SMACY2017/AI-Wings/README.md

# AI Wings Project

> Hold by the Microsoft Garage GCR for Hackathon 2023

## Related SharePoint Resources

[AI Wings sharepoint](https://microsoft.sharepoint.com/:f:/t/TheGarageBeijing/ElnYJoaCk3hEr9XLdqNrPawBjEY0E-VvGR7ijOIGqmrDCg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)

## Brief Introduction

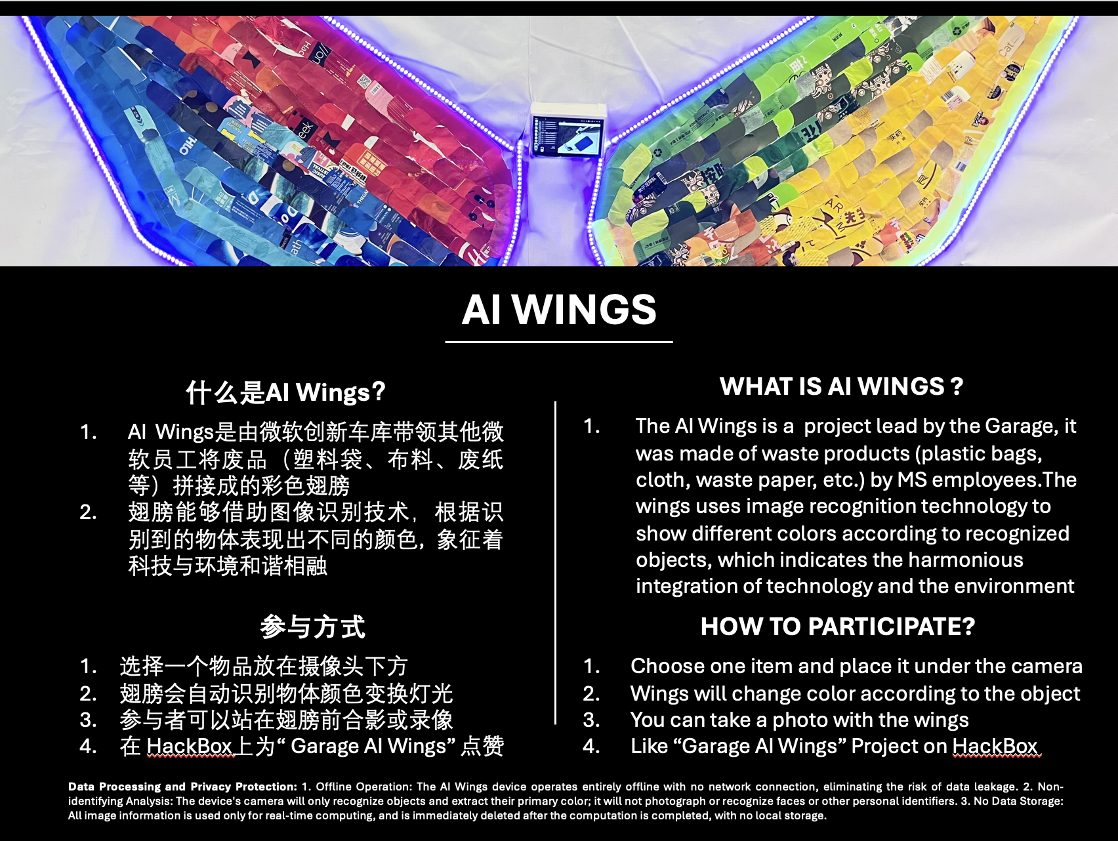
[picture p1: assets/Intro.png]
Intro


## Technique Details
**[所需材料以及技术文档请参见这里](https://github.com/SMACY2017/AI-Wings/tree/main/code)**

## Assembly details

#### **注：需要2-3名Leader全程负责翅膀的整个流程直到布置上线**

1. 取出背景布，平铺在桌面上，布面尺寸 `2.3 m * 3.05 m`。

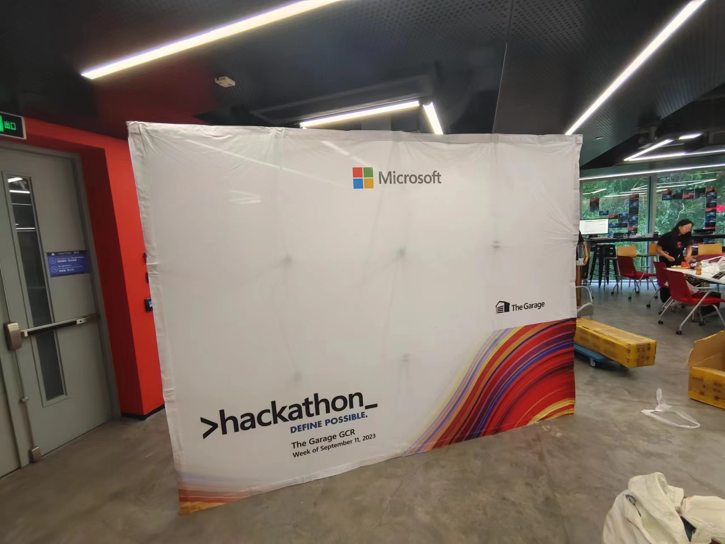
[picture p2: assets/background.jpg]
background
   
2. 勾勒翅膀外观尺寸和硬件电路固定。

   > 推荐人数：8 人（粘贴轮廓 4人， 灯带等硬件 4人 + 2 个Leader）
   >
   > 推荐场次：1 场（该场活动安排在[@MengShi](mailto:v-mengshi@microsoft.com)以及[@Xiang Yu](mailto:v-xiangyu1@microsoft.com)到达的第一天）
   >
   > 推荐时间：60 min
   >

   根据 `./utils/wings.png`（1.4m * 2.9 m）用铅笔在布面同比例进行关键点尺寸标定，先在周围粘贴一圈羽毛进行轮廓敲定。然后使用细铁丝加胶带等材料进行灯带的固定，以及电路的布局和固定。

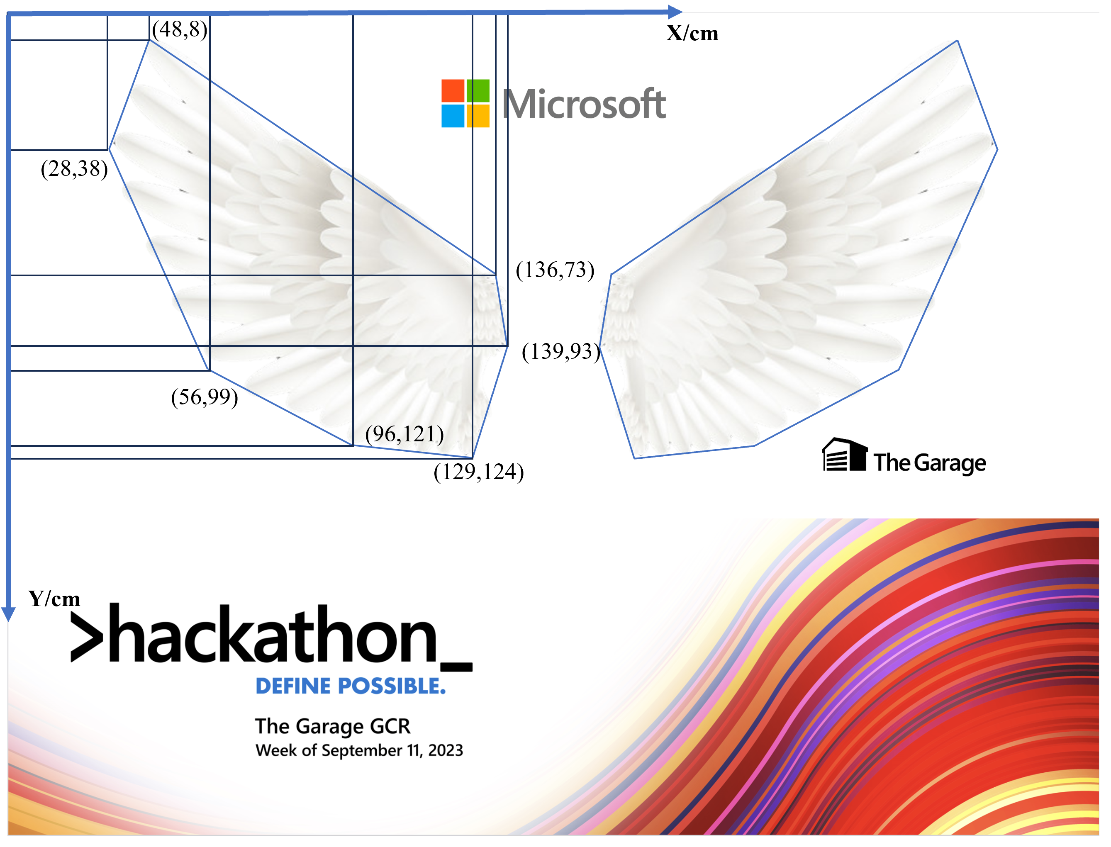
[picture p3: assets/backgroung.png]
backgroung
   

   <p align="center">
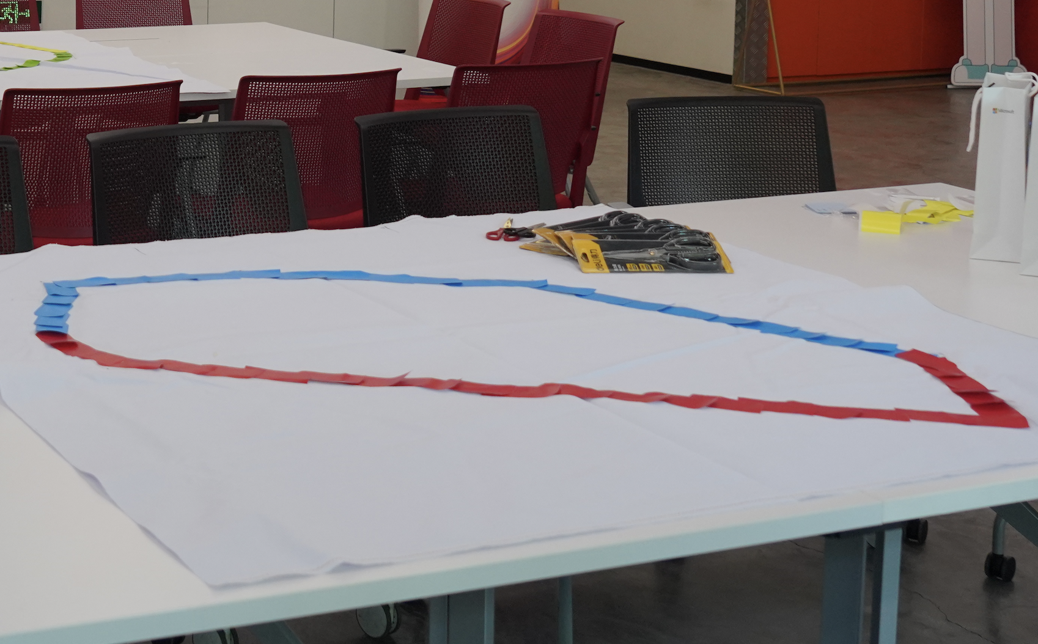
[picture p4: assets/outline-2341196.png]
outline
        
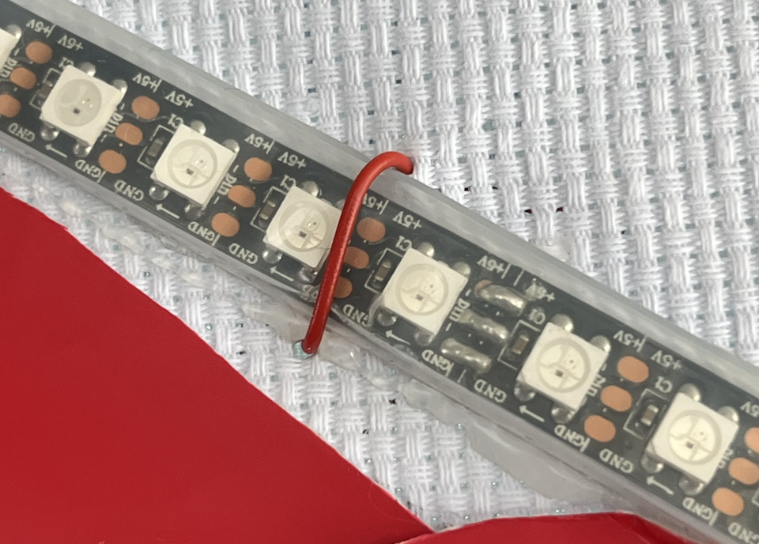
[picture p5: assets/zadai.png]
zadai
     
   </p>
3. **要求参与者携带微软四色（红、绿、蓝、黄）的垃圾袋**，SiteLead 打印翅膀模版文件 `./utils/feather.pdf`发给参与者，参与者们按照提供的翅膀模版图片进行剪裁**（不推荐使用塑料袋等薄而易卷的材料）**。

   > 推荐人数：40 人（每颜色10人剪裁翅膀，200片羽毛/颜色，平均每人裁剪20片）
   >
   > 推荐场次：2 场（20人/场）
   >
   > 推荐时间：45 min / 场（5 min讲解，讲解PPT参考[Garage 线下工作坊 亲手制作AI翅膀.pptx (sharepoint.com)](https://microsoft.sharepoint.com/:p:/r/teams/TheGarageBeijing/_layouts/15/Doc.aspx?sourcedoc={BF3407C9-1596-4903-8D87-60C0FF299C23}&file=Garage 线下工作坊 亲手制作AI翅膀.pptx&action=edit&mobileredirect=true&share=IQHJBzS_lhUDSY2HYMD_KZwjAZ7fnG6qvlRCYcBTRel2ibE)）
   >

   - 剪裁完成后，需要**留下8人进行两边翅膀的粘贴工作，SiteLead进行粘贴品控的监督**。
   - 粘贴羽毛时，采用层叠样式，从翅尖到翅根，一片盖一片
   - 翅膀需要加压晾干一天

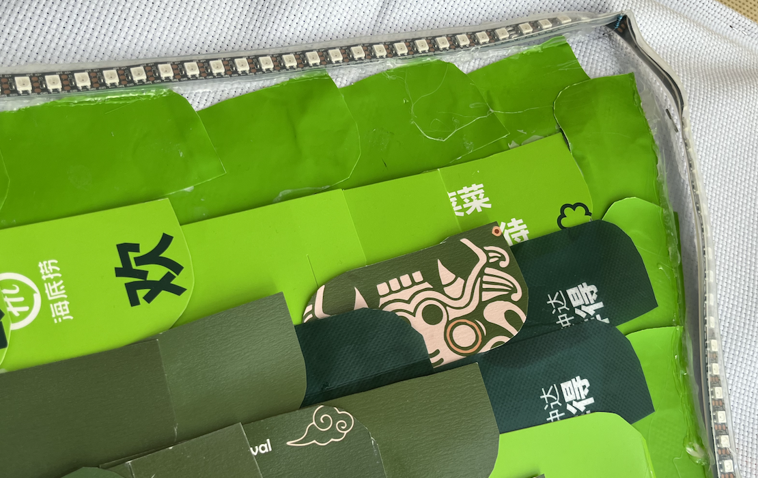
[picture p6: assets/Screenshot 2023-08-18 at 14.39.10.png]
     
4. Leader（组织2-3人）进行最后的组装和维护

   > 推荐人数：2 人
   >
   > 以下内容将会在第一场活动的时候由 Intern 向各个Site的Leader进行具体演示
   >

   - 显示屏安装、固定、接线
   - 灯带接线
   - 电源、启动、开关机

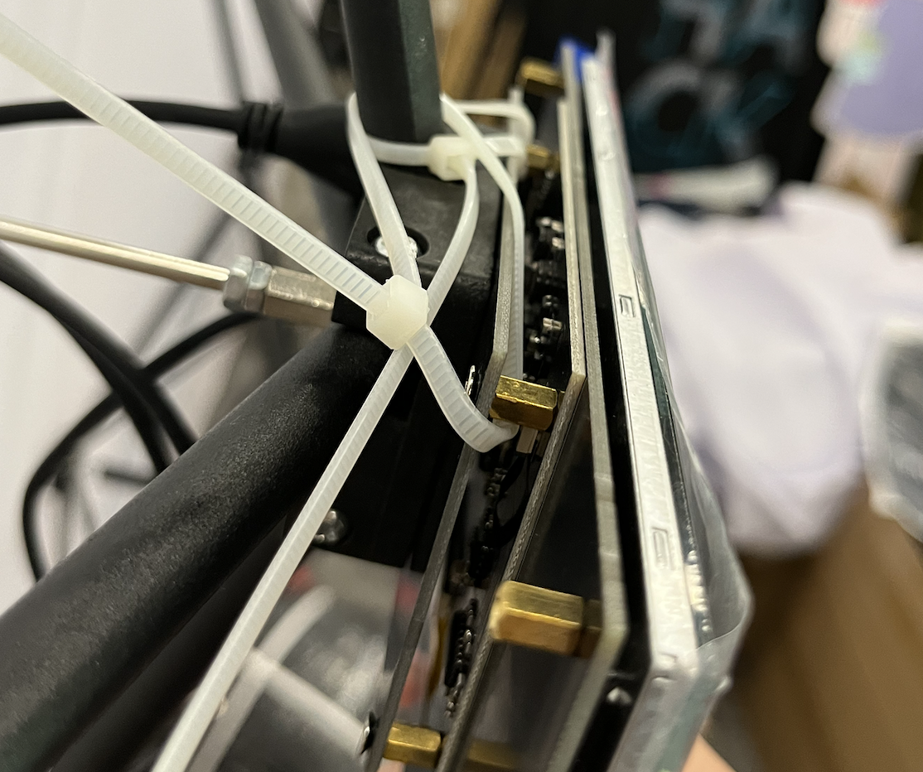
[picture p7: assets/Screenshot 2023-08-18 at 14.28.03.png]
     

### SiteLead ToDo

> 以下问题需要SiteLead配合，提出可行解决方案

- [ ] 展示完毕后的放置和收纳
- [ ] 由谁来接管这套设备，如何收纳
- [ ] 如何将装置利益最大化
