SMACY2017/AI-Wings/utils/feather.pdf

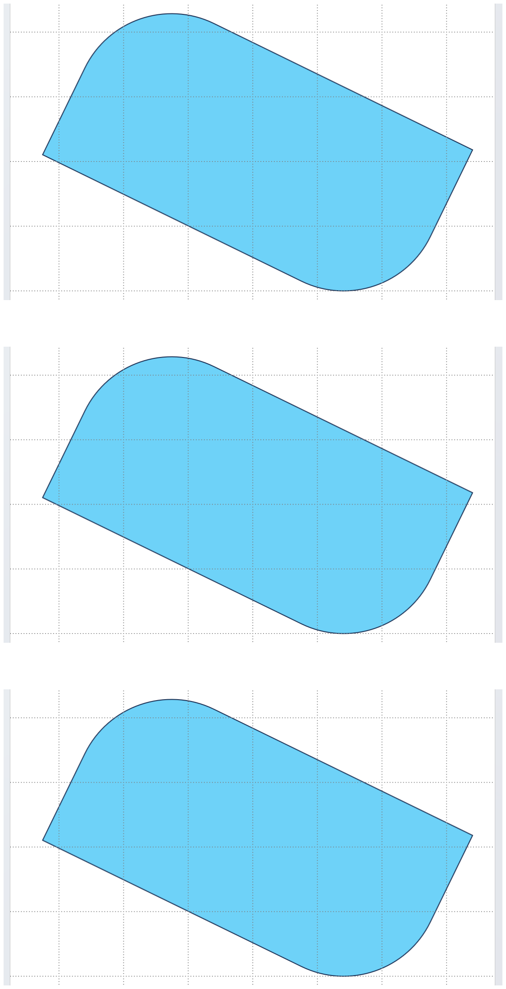
[picture p11: page 1]
