SMACY2017/AI-Wings/assets/BJG06219.jpeg

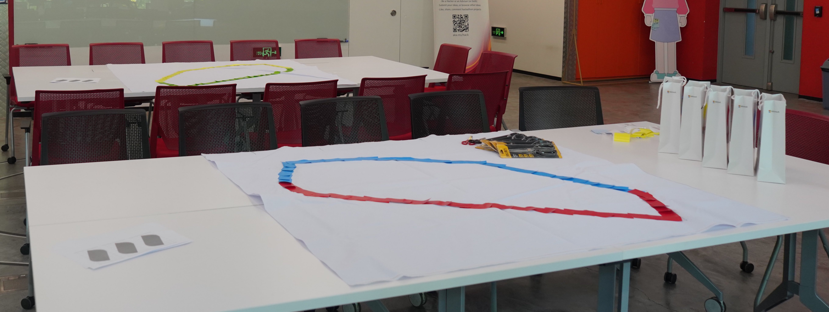
assets/BJG06219.jpeg
