SMACY2017/AI-Wings/(commit log)

2023-08-21 Update README.md
    完善开机自启打包部分
2023-08-21 划分为技术文档与组装细节文档
2023-08-21 修改超链接样式
2023-08-28 修改conda安装教程
